pdxbadgers/badge-2019/README.md

# badge-2019
## Ideas
Rigado BMD-3XX SoC  
Two prototype boards  
Better power management  
Badge hacking/game/CTF  
Badge to Badge interaction  
600 Badges  
BOM below $15.00  
FW and HW Teams  

## Badge Art Ideas
Victorian Belle shape  
Flaming babgepipe on unicycle  
Boat  
Multnomah Falls
