pdxbadgers/badge-2019/(commit log)

2019-09-02 Added 3D model for LED, SAO header symbol
    [multnomah.kicad_pcb, multnomah.sch]
2019-09-02 Added BADGE SAO connector updated MCU footprint and routing Added 3D models for LEDs Moved Resistors and silk
    [multnomah.kicad_pcb, multnomah.sch]
2019-09-02 add .gitignore for kicad
2019-09-02 add footprint and sym library
2019-09-02 connected SAO & changed resistor footprint to hand solder
    [multnomah.kicad_pcb]
2019-09-02 flipped battery holder & rotated corner LED's 13 & 36
    [multnomah.kicad_pcb]
2019-09-02 removed all traces from water
    [multnomah.kicad_pcb]
2019-09-02 couple of cosmetic tweaks: SAO silk + copper signature overlay
    [multnomah.kicad_pcb]
2019-09-02 tiny cosmetic update
    [multnomah.kicad_pcb]
2019-09-02 Added symbol, footprint, 3D files for switch. Added switch to schematic and layout Added author to B.Silk Moved R5 R6 B.Silk
    [multnomah.kicad_pcb, multnomah.sch]
2019-09-02 fixing slik screen problem
    [multnomah.kicad_pcb]
2019-09-02 inverted mask
    [multnomah.kicad_pcb]
2019-09-02 added BoM file
    [BoM.csv]
2019-09-13 fixed via short
    [multnomah.kicad_pcb, multnomah.sch]
2019-09-13 flipped LED's 10 & 19 to fix waterflow
    [multnomah.kicad_pcb]
2019-09-13 added fiducials
    [multnomah.kicad_pcb]
2019-09-13 removed cap resistors
    [multnomah.kicad_pcb]
2019-09-13 fixed cosmetic via on tree
    [multnomah.kicad_pcb]
2019-09-13 fixed LED footprint + schematic annotations
    [multnomah.kicad_pcb]
2019-09-13 updated schematic - annotations + deleted resistors
    [multnomah.kicad_pcb, multnomah.sch]
2019-09-13 updated BoM
    [BoM.csv]
2019-09-13 changed LED footprint cover from mask to silk
    [multnomah.kicad_pcb]
2019-09-13 moved LED silk so it wont get cut off by via bare board
    [multnomah.kicad_pcb]
2019-09-13 fixed silk for D23
    [multnomah.kicad_pcb]
